ti5lx/COBRA138MOD/cobra138xlr_schematic.pdf

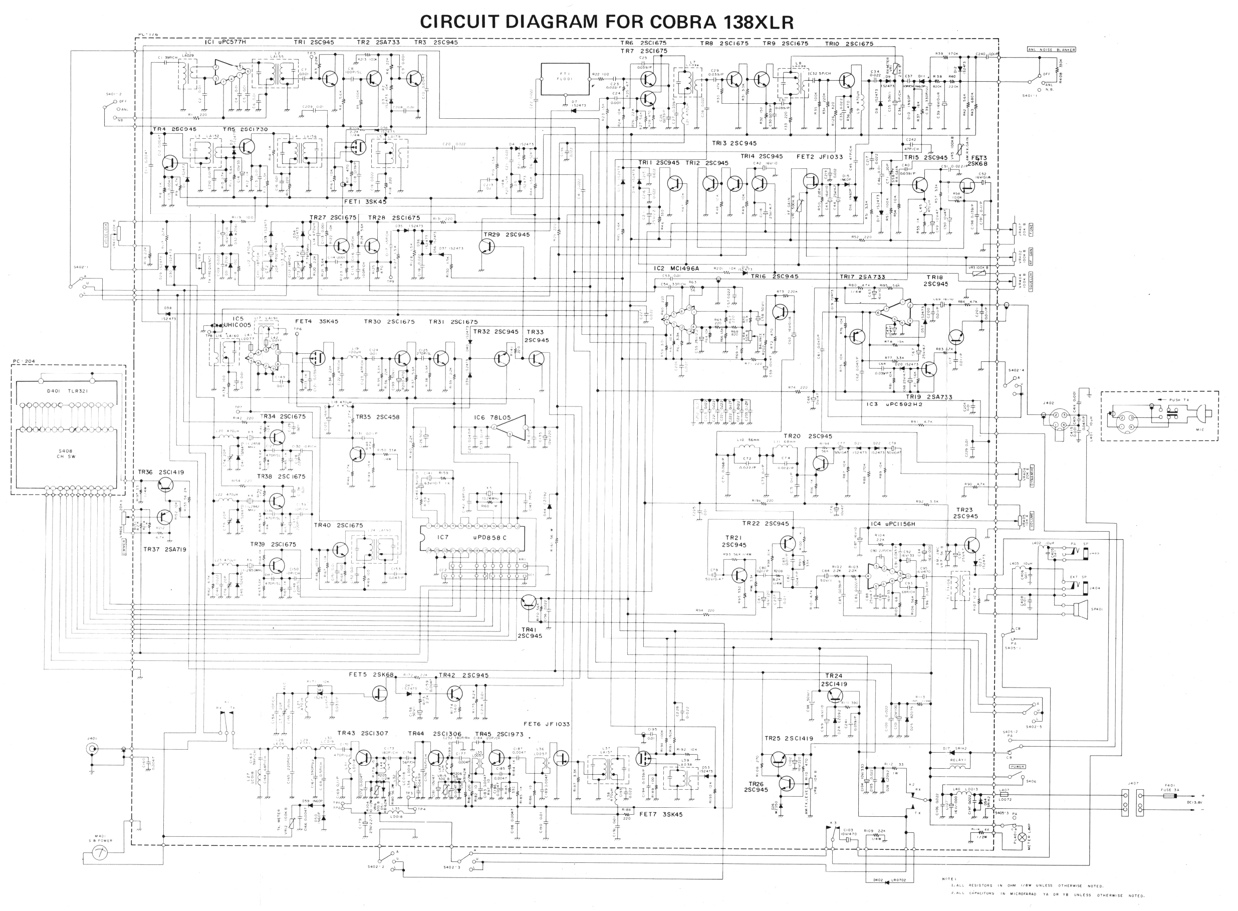
[picture p1: page 1]
