ti5lx/COBRA138MOD/138ModSch.pdf

### SCL

### SDA

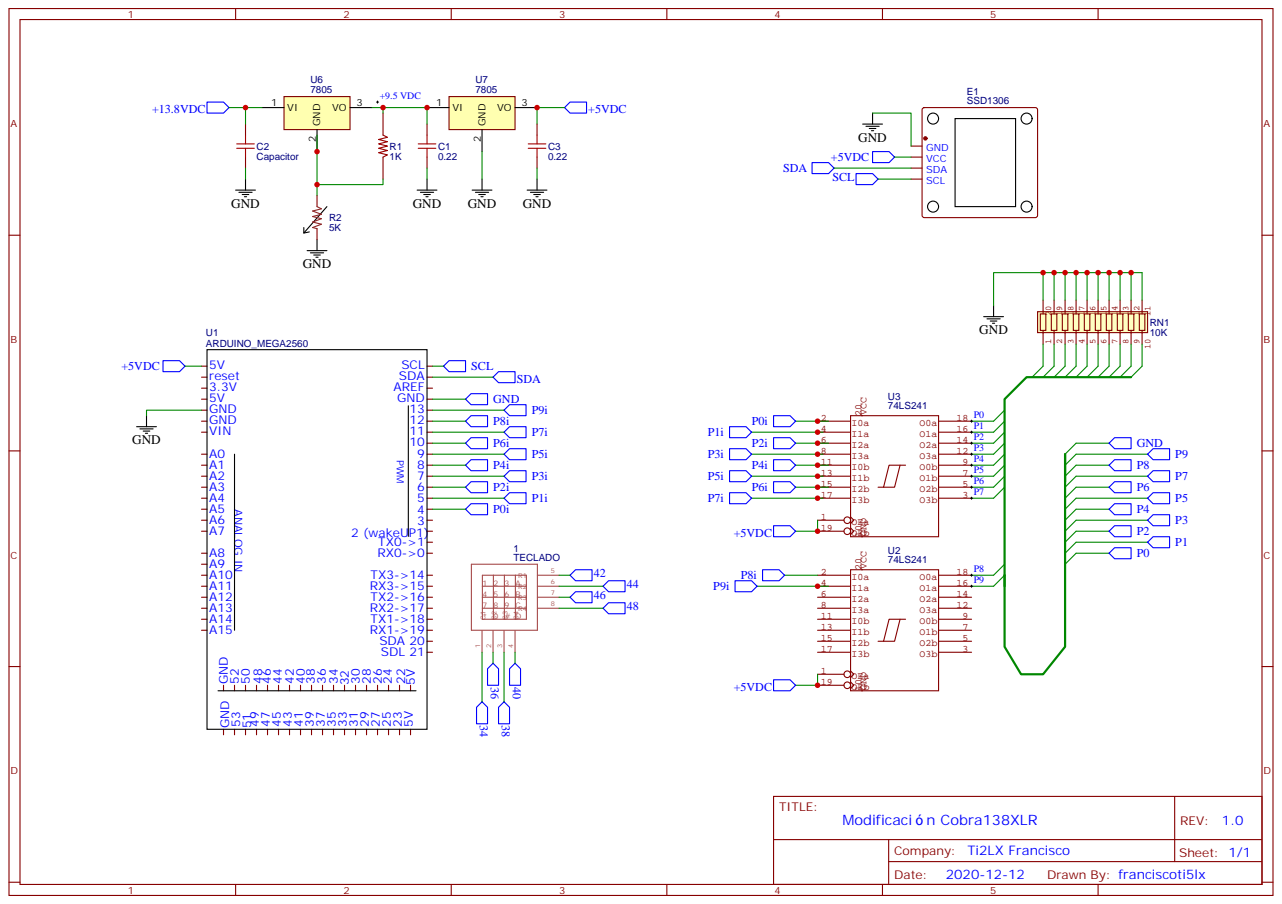
[picture p30: page 1]

1 | 2 | 3 | A R2
4 | 5 | 6 | B R3
7 | 8 | 9 | C R4
